neilgibsonpinto-art/Arduino-Nano-Line-Follower-PCB/Docs/BOM.csv

Reference | Qty | Value | Footprint | LINK
C1,C2 | 2 | 10µF | Capacitor_THT:CP_Radial_D5.0mm_P2.00mm | https://robu.in/product/10-uf-25v-through-hole-electrolytic-capacitor-pack-of-40/
CALIBRATION1,START1 | 2 | SW_Push | Button_Switch_THT:SW_PUSH_6mm | https://robu.in/product/tsd001a06018a-bzcn-6mm-6mm-50ma-round-button-direct-insert-6mm-180gf-12v-plugin-tactile-switches-rohs/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
D1 | 1 | D_Schottky | Diode_SMD:D_SMA | https://robu.in/product/ss34-slkor-40v-500mv3a-3a-smado-214ac-schottky-diodes-rohs/
D2 | 1 | LED | LED_THT:LED_D5.0mm | https://robu.in/product/5mm-red-dip-led-pack-of-50/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
J1 | 1 | Conn_01x10_Pin | Connector:JST_B10B-XH-A_LF__SN_ | https://robu.in/product/b10b-xh-amlfsn-jst-1x10p-10p-xh-tin-10-25%E2%84%8385%E2%84%83-3a-1-2-5mm-brass-direct-insert-pluginp2-5mm-wire-to-board-connector-rohs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
J2 | 1 | Conn_01x02 | Connector:screw_conn | https://robu.in/product/xy306a-5-0-xinya-2-pin-screw-terminal-blockblue/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
J3,J4 | 2 | S2B-PH-K-S_LF__SN_ | Connector:jst_2pin | https://robu.in/product/2-pin-jst-xh-2-54mm-pitch-plug-and-socket-with-cable-10-pcs/?gad_source=4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
SW1 | 1 | SW_SPDT | Socket:SW_MINI-SPDT-SW | https://robu.in/product/1-month-warranty-255/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
U1 | 1 | ARDUINO_NANO | ARDUINO:MODULE_ARDUINO_NANO | https://robu.in/product/arduino-nano-board-r3-ch340-chip-with-usb-cable-solderedarduino-nano-r3-usb-cable/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
U2 | 1 | ROB-14450 | ARDUINO:MODULE_ROB-14450 | https://robu.in/product/motor-driver-tb6612fng-module-performance-ultra-small-volume-3-pi-matching-performance-ultra-l298n/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
U3 | 1 | LM7805_TO220 | Package_TO_SOT_THT:TO-220-3_Vertical | https://robu.in/product/l7805cv-stmicroelectronics-linear-voltage-regulator-7805-fixed-positive-10v-to-35v-in-5v-and-1-5a-out-to-220-3/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
heat sink | 1 |  |  | https://robu.in/product/to220-718-aluminum-heatsink-for-transistor-pack-of-5/
10 pin housing | 2 |  |  | https://robu.in/product/xh-a-aw-2-5mm-10-pin-housing-connector-female/
