neilgibsonpinto-art/Arduino-Nano-Line-Follower-PCB/LINE FOLLOWER PCB.step

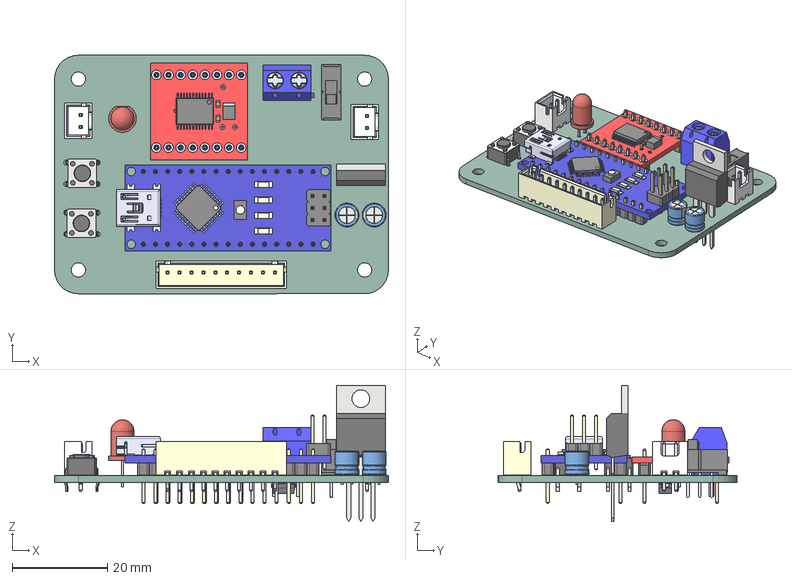
[picture p1: CAD file, 2026-10-13]
LINE FOLLOWER PCB.step
70.0 x 50.0 x 28.5 mm
SW_PUSH_6mm x 2
ROB-14450
B10B-XH-A_LF__SN_
CP_Radial_D5.0mm_P2.00mm x 2
LED_D5.0mm
TO-220-3_Vertical
MINI-SPDT-SW
ARDUINO_NANO
BxB-XH-A_02 x 2
KF301-2P
D_SMA
lineFollow_PCB
