neilgibsonpinto-art/Arduino-Nano-Line-Follower-PCB/Docs/Schematic.pdf

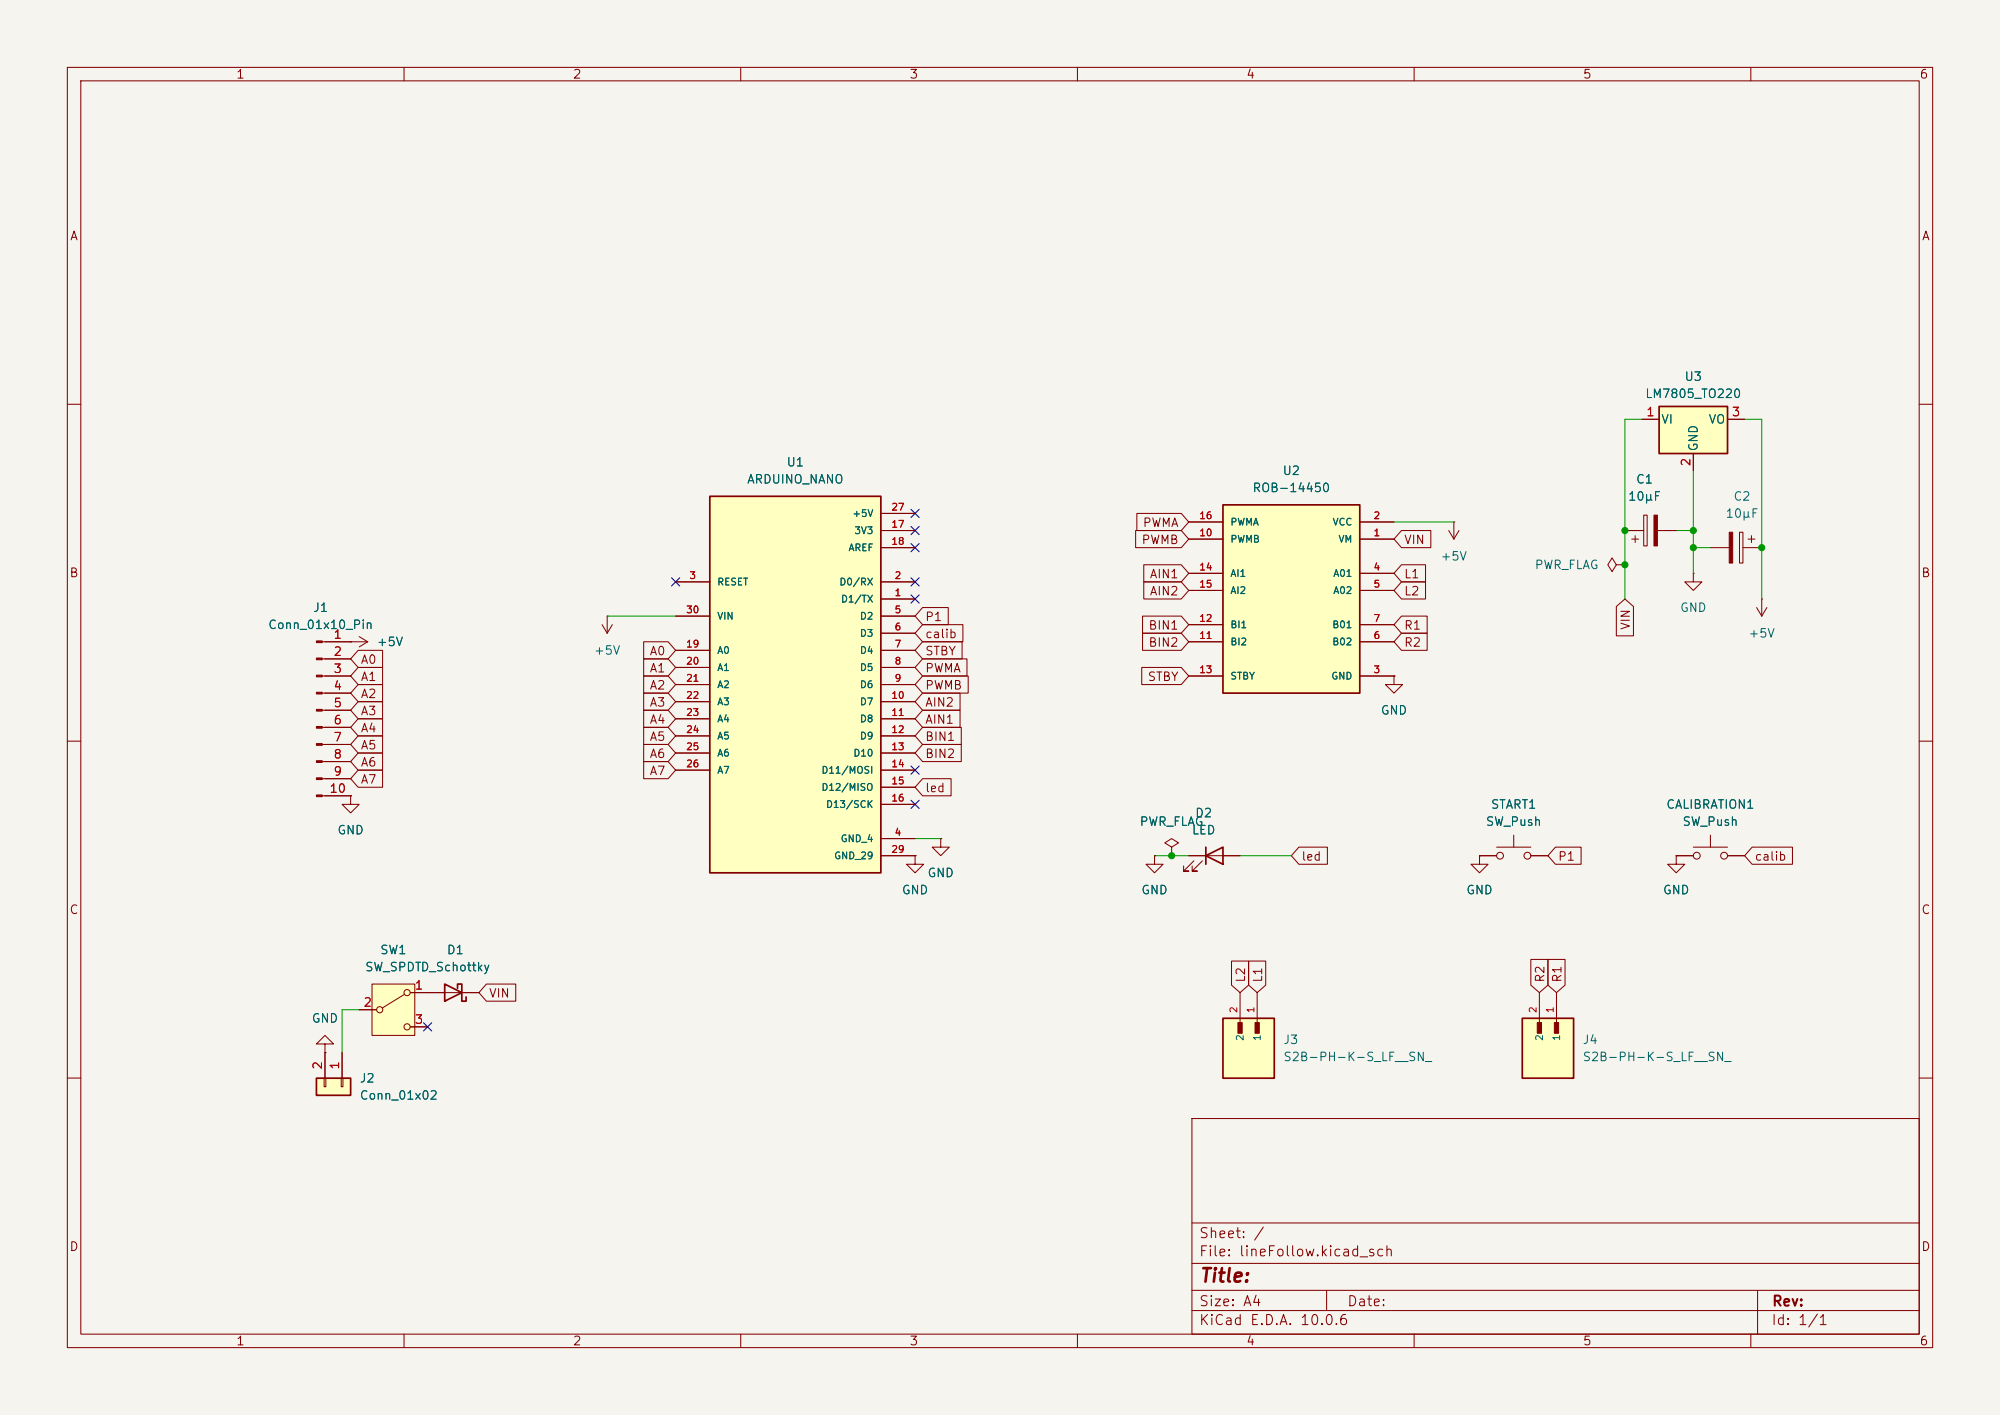
[picture p2: page 1]

Size: A4 | Rev:
KiCad E.D.A. 10.0.6 | Id: 1/1
