neilgibsonpinto-art/Arduino-Nano-Line-Follower-PCB/(list of files, drawings)

Other design files:
freerouting.dsn
