neilgibsonpinto-art/Arduino-Nano-Line-Follower-PCB/lineFollow.kicad_pcb

## KiCad design lineFollow.kicad_pcb (2026-10-13)

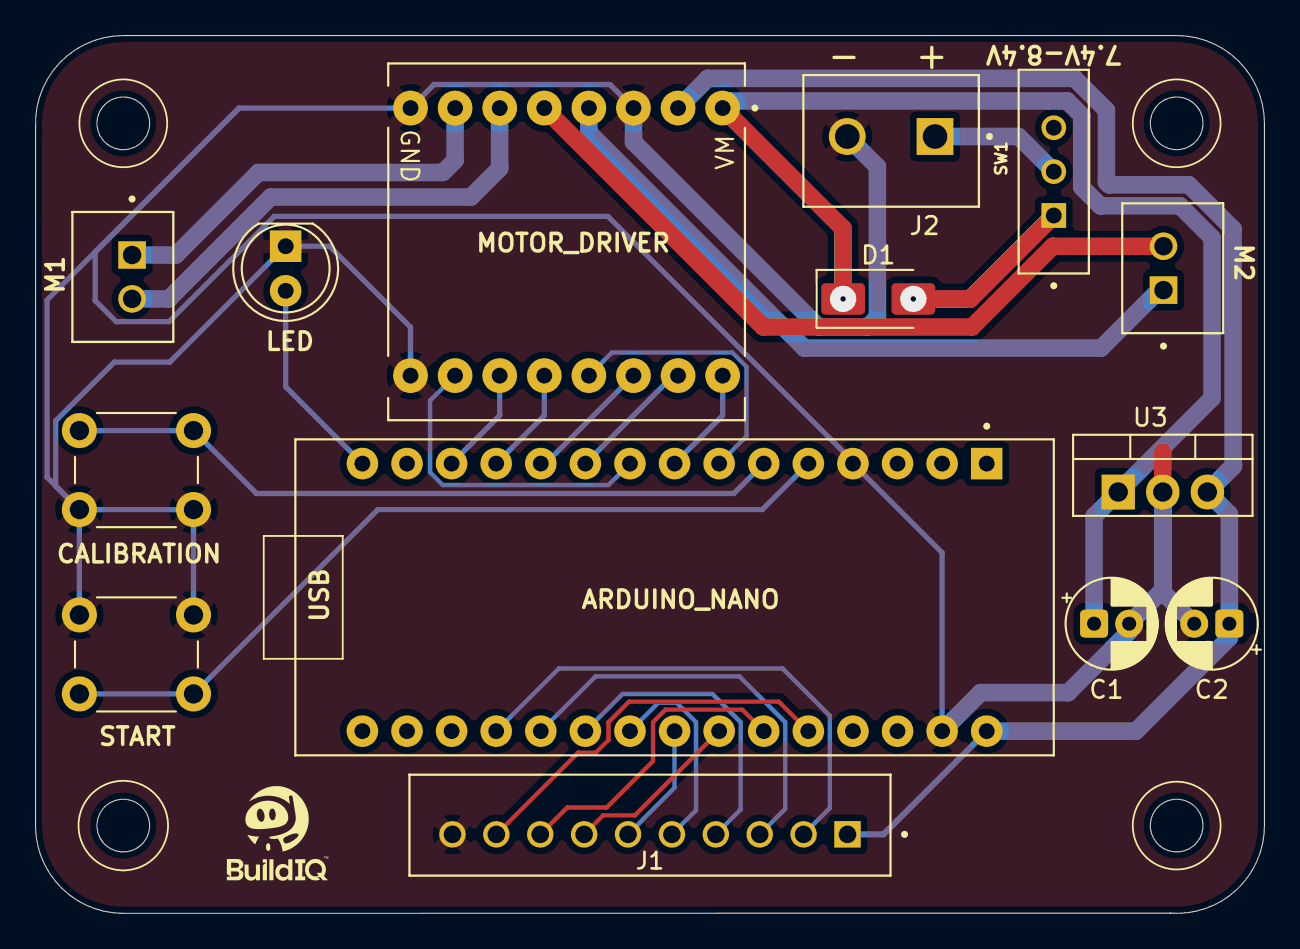
[picture p3: board lineFollow.kicad_pcb from above]

Board: 2 copper layers, 70.0 x 50.0 mm, 14 parts (0 on the bottom side), 27 nets.

Parts:
C1, C2: 10µF; CP_Radial_D5.0mm_P2.00mm
CALIBRATION_1: SW_Push; SW_PUSH_6mm
D1: D_Schottky; D_SMA
D2: LED; LED_D5.0mm
J1: Conn_01x10_Pin; JST_B10B-XH-A_LF__SN_
J2: Conn_01x02; screw_conn
J3, J4: S2B-PH-K-S_LF__SN_; jst_2pin
START_1: SW_Push; SW_PUSH_6mm
SW1: SW_SPDT; SW_MINI-SPDT-SW
U1: ARDUINO_NANO; MODULE_ARDUINO_NANO
U2: ROB-14450; MODULE_ROB-14450
U3: LM7805_TO220; TO-220-3_Vertical

Connections:
+5V: C2.1, J1.1, U1.30 (VIN), U2.2 (VCC), U3.3 (VO)
A0: J1.2, U1.19 (A0)
A1: J1.3, U1.20 (A1)
A2: J1.4, U1.21 (A2)
A3: J1.5, U1.22 (A3)
A4: J1.6, U1.23 (A4)
A5: J1.7, U1.24 (A5)
A6: J1.8, U1.25 (A6)
A7: J1.9, U1.26 (A7)
AIN1: U1.11 (D8), U2.14 (AI1)
AIN2: U1.10 (D7), U2.15 (AI2)
BIN1: U1.12 (D9), U2.12 (BI1)
BIN2: U1.13 (D10), U2.11 (BI2)
GND: C1.2, C2.2, CALIBRATION_1.1, D2.1 (K), J1.10, J2.2, START_1.1, U1.4 (GND_4), U1.29 (GND_29), U2.3 (GND), U2.8 (GND), U2.9 (GND), U3.2 (GND)
L1: J3.1, U2.4 (A01)
L2: J3.2, U2.5 (A02)
unnamed: D1.2 (A), SW1.1 (A)
unnamed: J2.1, SW1.2 (B)
P1: START_1.2, U1.5 (D2)
PWMA: U1.8 (D5), U2.16 (PWMA)
PWMB: U1.9 (D6), U2.10 (PWMB)
R1: J4.1, U2.7 (B01)
R2: J4.2, U2.6 (B02)
STBY: U1.7 (D4), U2.13 (STBY)
VIN: C1.1, D1.1 (K), U2.1 (VM), U3.1 (VI)
calib: CALIBRATION_1.2, U1.6 (D3)
led: D2.2 (A), U1.15 (D12/MISO)
