neilgibsonpinto-art/Arduino-Nano-Line-Follower-PCB/(commit log)

2026-08-04 Revise README for Arduino Nano Line Follower Robot
    Expanded project description and added detailed features, hardware specifications, repository structure, software requirements, future improvements, and author information.
2026-08-04 Add Arduino Nano PID Line Follower firmware
2026-10-13 Add complete hardware design files, Gerbers, 3D model, documentation, and PID firmware
    [BOM.csv, LINE FOLLOWER PCB.step, freerouting.dsn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]
