neilgibsonpinto-art/Arduino-Nano-Line-Follower-PCB/(notices)

Notices in the files:
README.md:
License: MIT
